ianfajar-codes/SPS-Enose-Project/Dokumentasi/3D Design Top.jpg

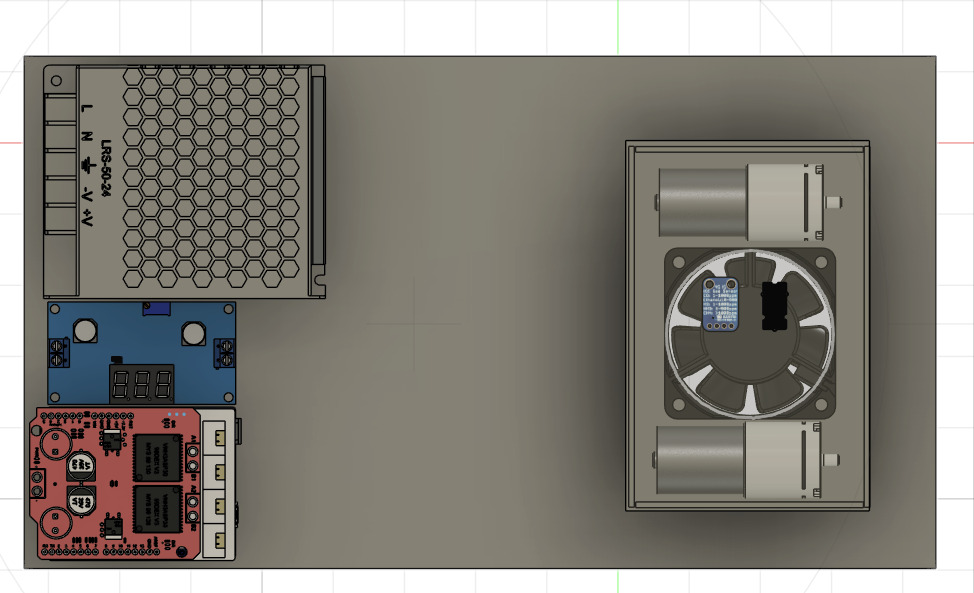
Dokumentasi/3D Design Top.jpg
