ianfajar-codes/SPS-Enose-Project/Dokumentasi/Pengambilan Data (1).jpg

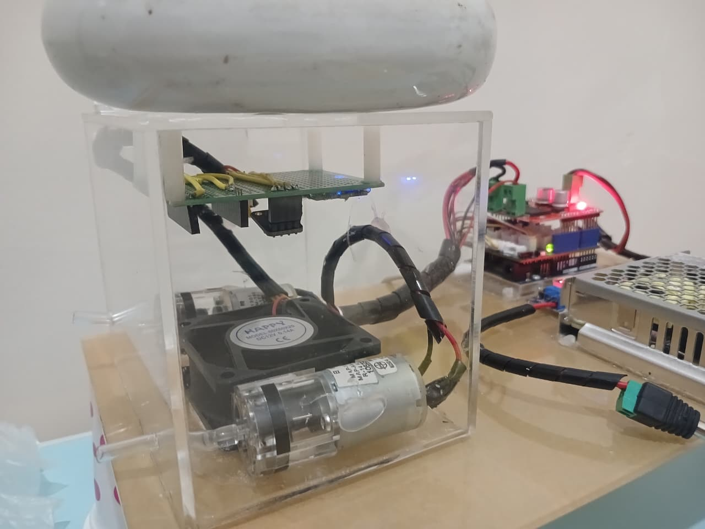
Dokumentasi/Pengambilan Data (1).jpg
