ianfajar-codes/SPS-Enose-Project/Dokumentasi/3D Design Back.jpg

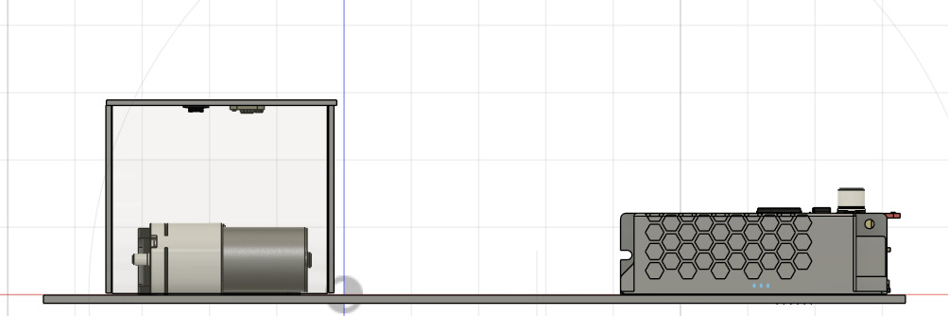
Dokumentasi/3D Design Back.jpg
