ianfajar-codes/SPS-Enose-Project/Dokumentasi/3D Design Left.jpg

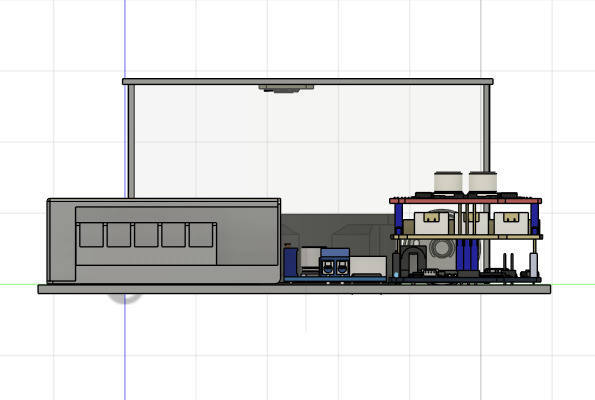
Dokumentasi/3D Design Left.jpg
