ianfajar-codes/SPS-Enose-Project/Dokumentasi/3D Design Right.jpg

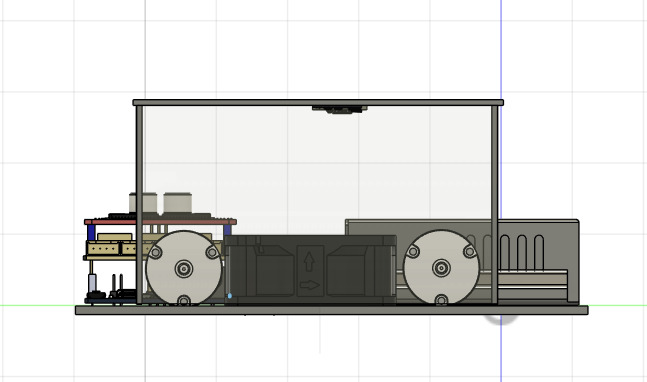
Dokumentasi/3D Design Right.jpg
