ianfajar-codes/SPS-Enose-Project/Dokumentasi/Edge Impluse Pompa 1.jpg

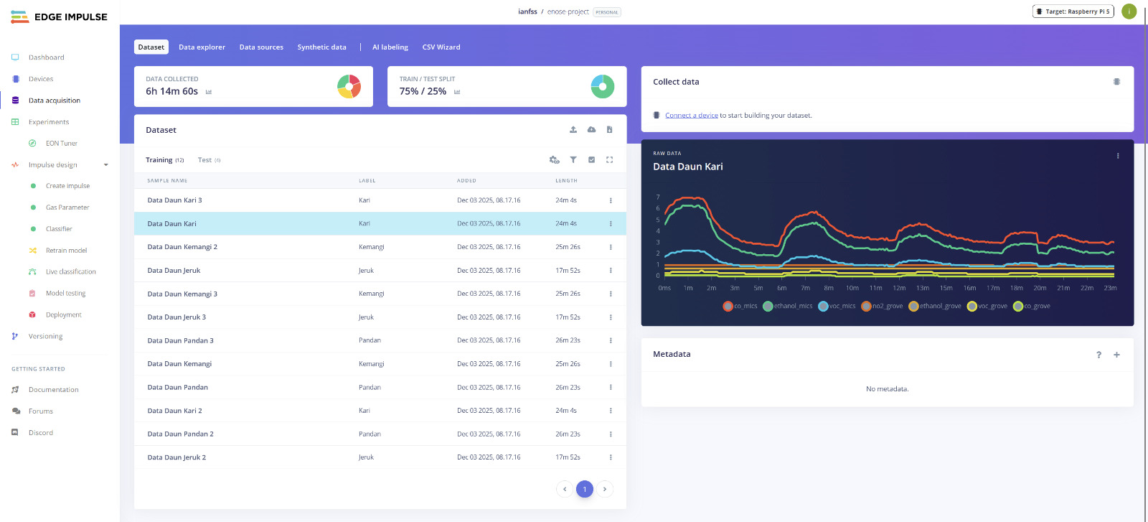
Dokumentasi/Edge Impluse Pompa 1.jpg
