ianfajar-codes/SPS-Enose-Project/Dokumentasi/Edge Impulse Kari.jpg

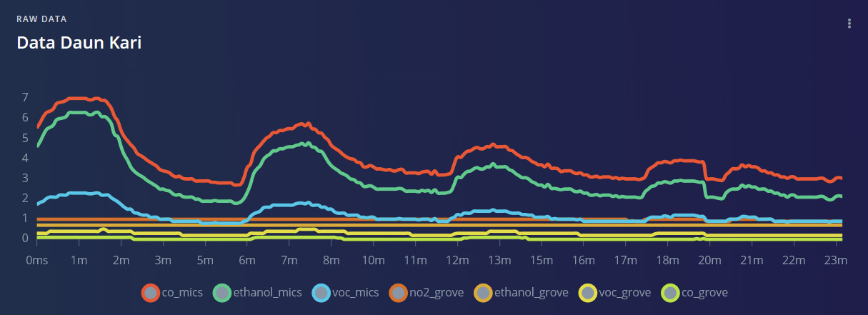
Dokumentasi/Edge Impulse Kari.jpg
