ianfajar-codes/SPS-Enose-Project/Dokumentasi/Edge Impulse Kemangi.jpg

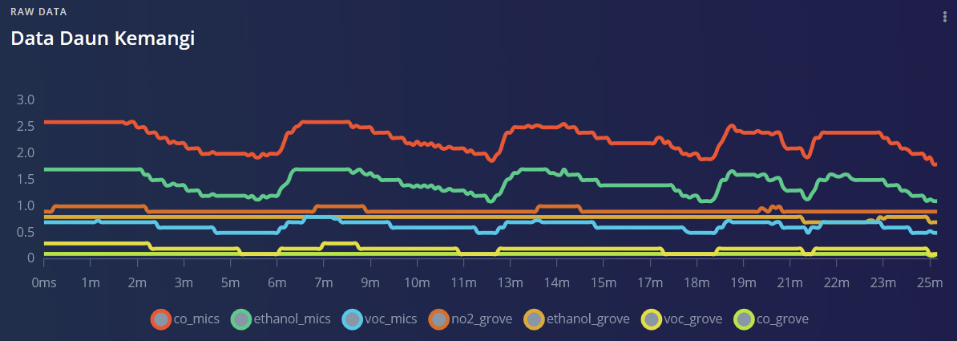
Dokumentasi/Edge Impulse Kemangi.jpg
