ianfajar-codes/SPS-Enose-Project/Dokumentasi/GNUPLOT jeruk.jpg

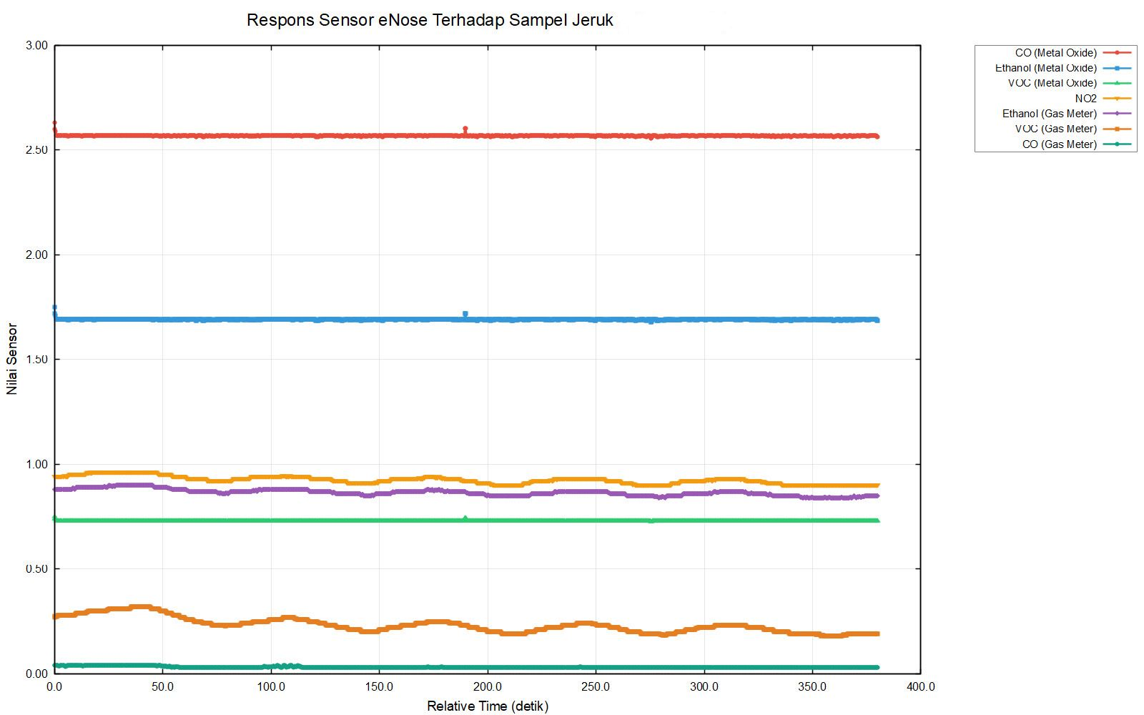
Dokumentasi/GNUPLOT jeruk.jpg
