ianfajar-codes/SPS-Enose-Project/Dokumentasi/Pengambilan Data (2).jpg

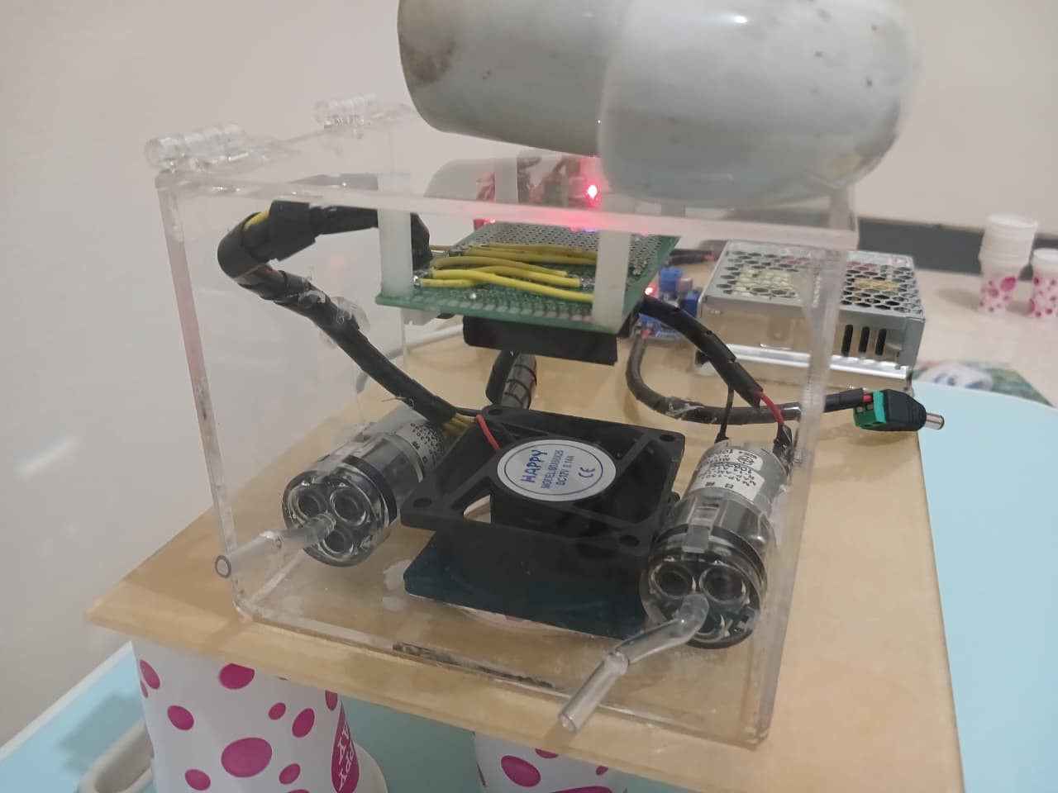
Dokumentasi/Pengambilan Data (2).jpg
