ianfajar-codes/SPS-Enose-Project/Dokumentasi/Pengambilan Data (3).jpg

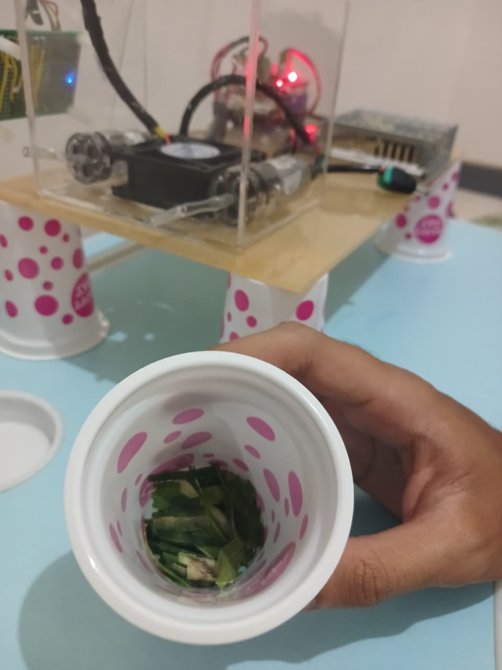
Dokumentasi/Pengambilan Data (3).jpg
