ianfajar-codes/SPS-Enose-Project/Dokumentasi/Tampilan GUI.jpg

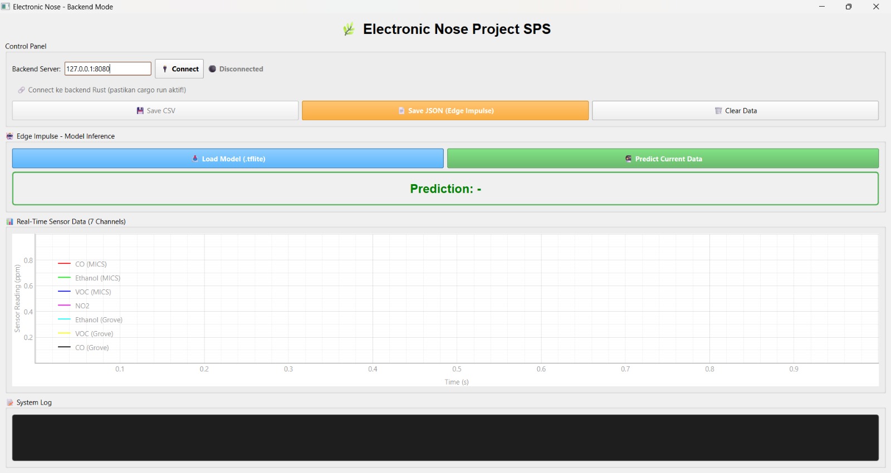
Dokumentasi/Tampilan GUI.jpg
